gioelemigno/Home-Net-System-Design-and-implementation-of-a-home-automation-system-for-energy-consumption-contro/Home Net System_  Presentation.pdf

Home Net System:

Design and implementation of a home automation system for energy consumption control

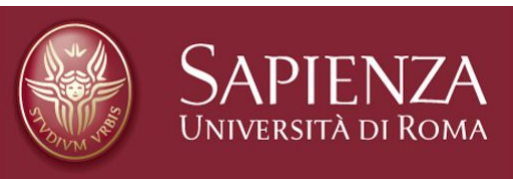
[picture p4: figure]

Candidate: | Gioele Migno 1795826
Thesis Advisor: | Prof. Alessandro Di Giorgio
Co-Advisor: | Prof. Vincenzo Suraci | 10/13/2020

## Introduction

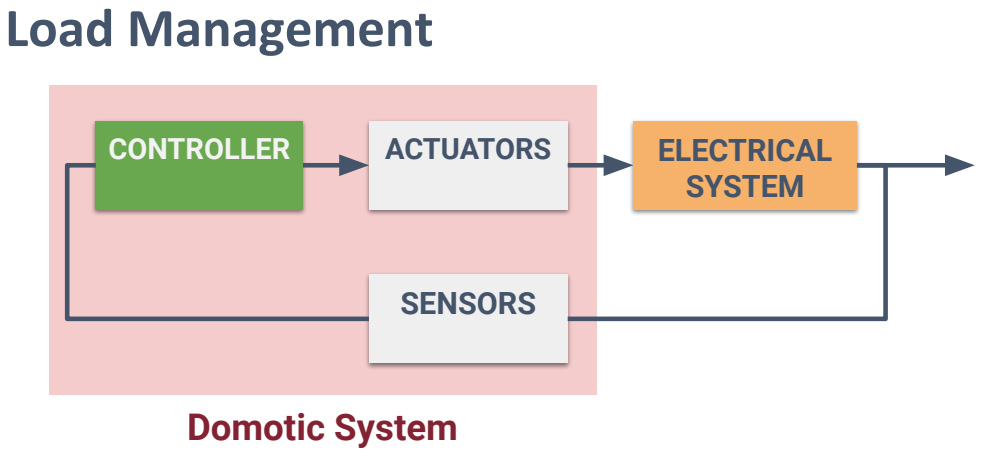
[picture p5: page 4]
CONTROLLER; ELECTRICAL; SYSTEM; SENSORS; ACTUATORS; Domotic System

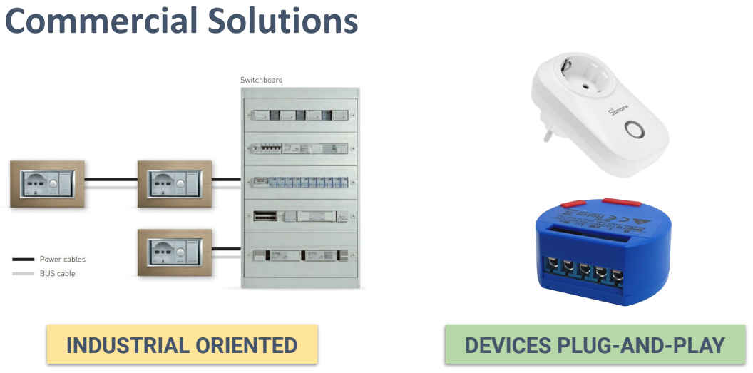
[picture p6: page 5]
INDUSTRIAL ORIENTED; DEVICES PLUG-AND-PLAY

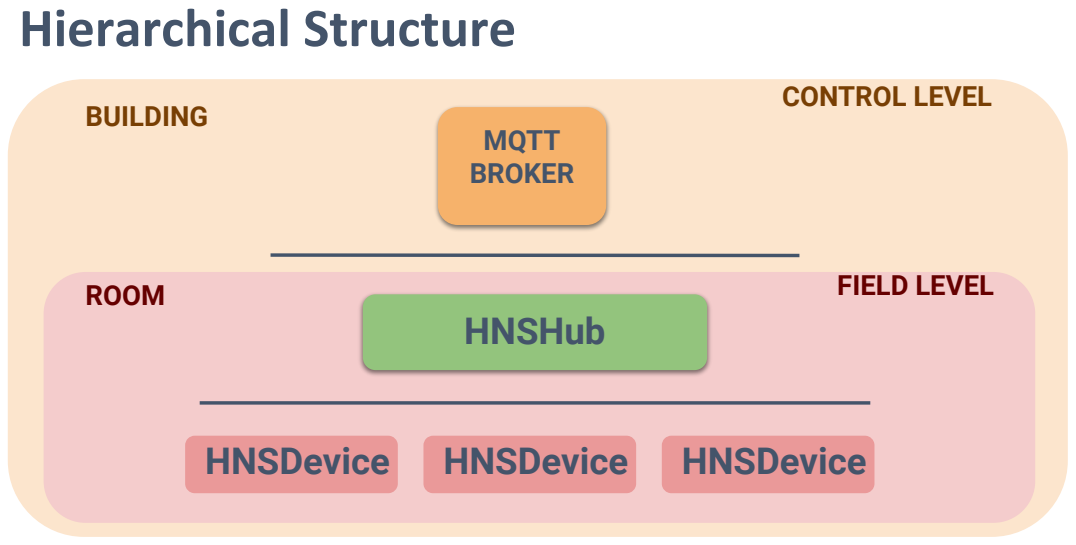
[picture p7: page 6]
HNSHub; MQTT BROKER; HNSDevice; ROOM; BUILDING; CONTROL LEVEL; FIELD LEVEL

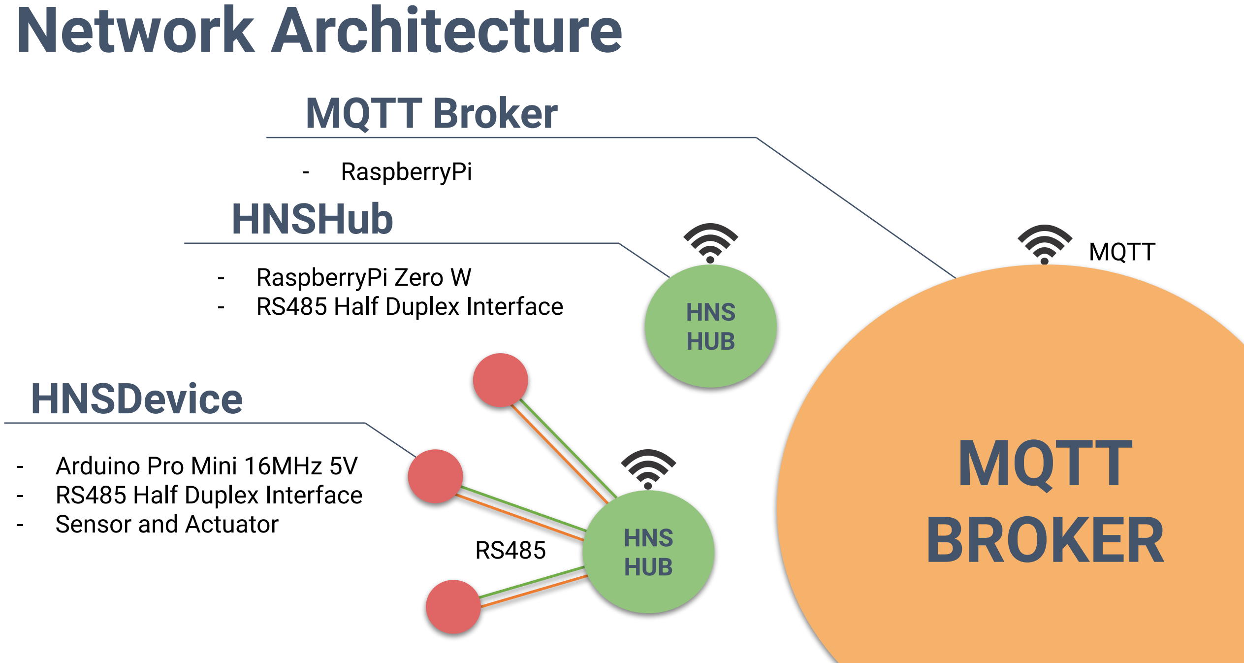
[picture p8: page 7]

HNS
HUB

Network Architecture

HNSDevice

- Arduino Pro Mini 16MHz 5V
- RS485 Half Duplex Interface
- Sensor and Actuator

HNSHub

- RaspberryPi Zero W
- RS485 Half Duplex Interface

MQTT Broker

- RaspberryPi
RS485 | HNS HUB

MQTT

MQTT
BROKER

Communication Example

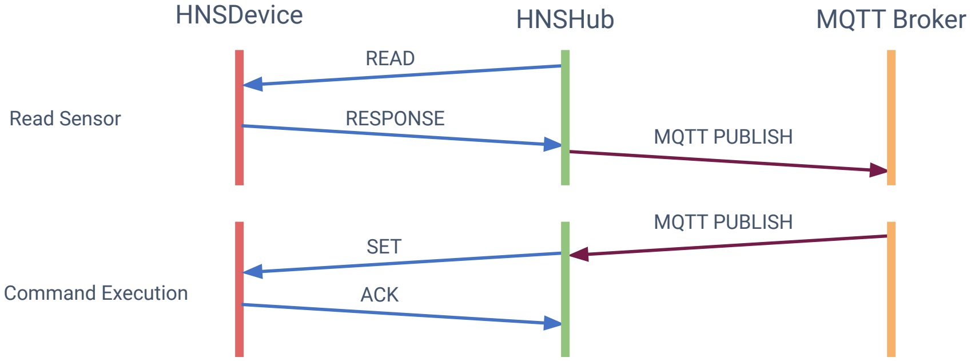
[picture p9: figure]
HNSDevice; HNSHub; MQTT Broker; Read Sensor; Command Execution; READ; RESPONSE; SET; ACK; MQTT PUBLISH

HNSProtocol | MQTT

## Proof of Concept

Hardware setup

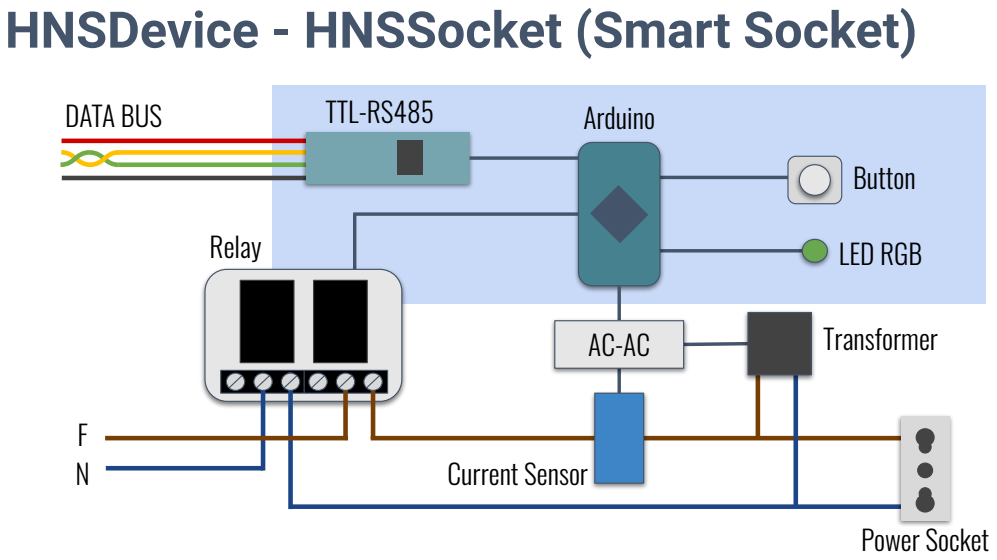
[picture p10: page 10]
Current Sensor; LED RGB; Button; Arduino; Relay; Transformer; DATA BUS; TTL-RS485; Power Socket

HNSDevice - HNSSocket (Smart Socket)

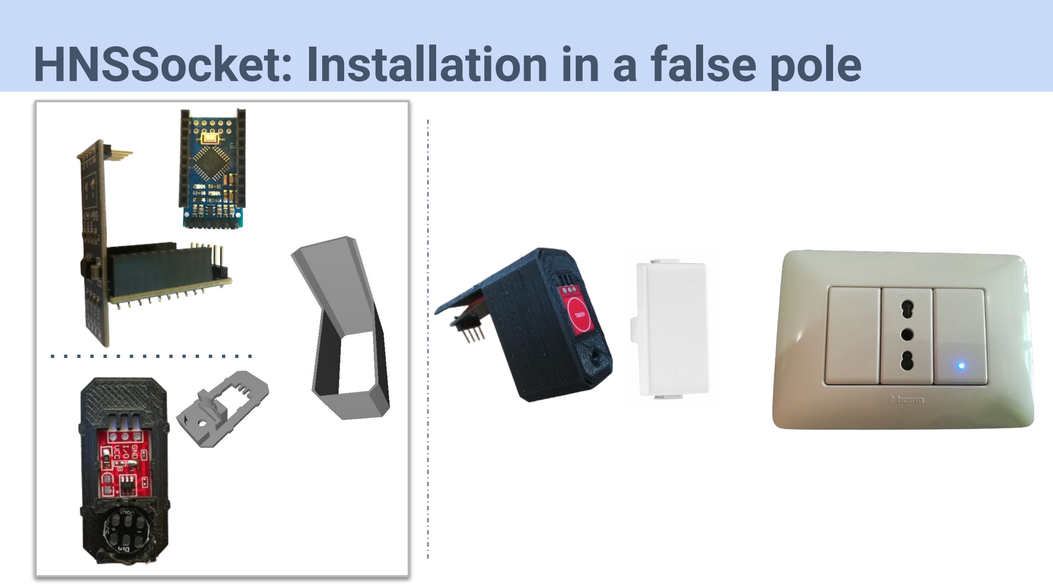
[picture p11: page 11]

HNSSocket: Installation in a false pole

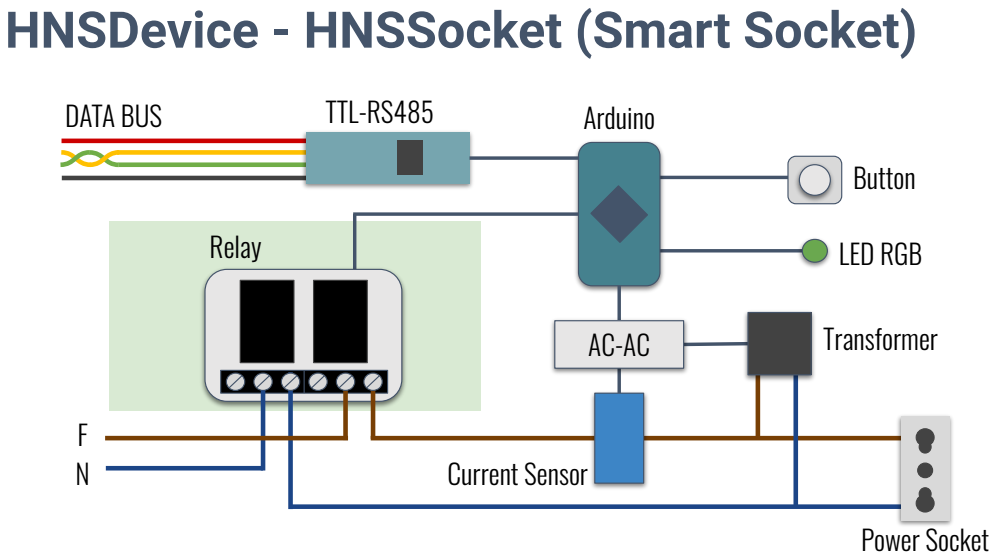
[picture p12: page 12]
Current Sensor; LED RGB; Button; Arduino; Relay; Transformer; DATA BUS; TTL-RS485; Power Socket

HNSDevice - HNSSocket (Smart Socket)

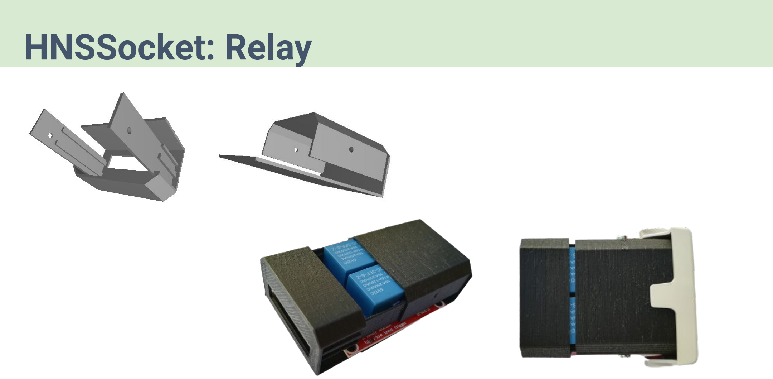
[picture p13: page 13]

HNSSocket: Relay

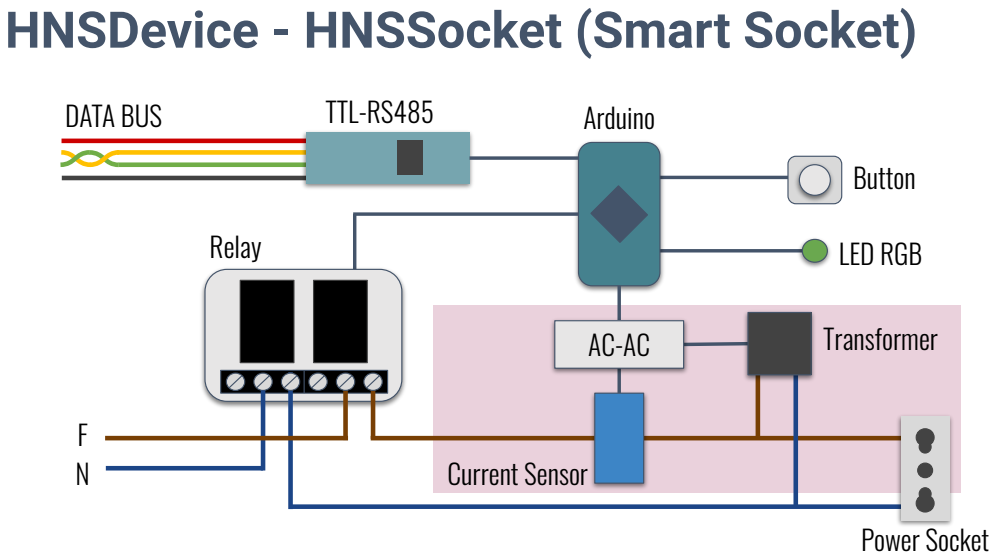
[picture p14: page 14]
Current Sensor; LED RGB; Button; Arduino; Relay; Transformer; DATA BUS; TTL-RS485; Power Socket

HNSDevice - HNSSocket (Smart Socket)

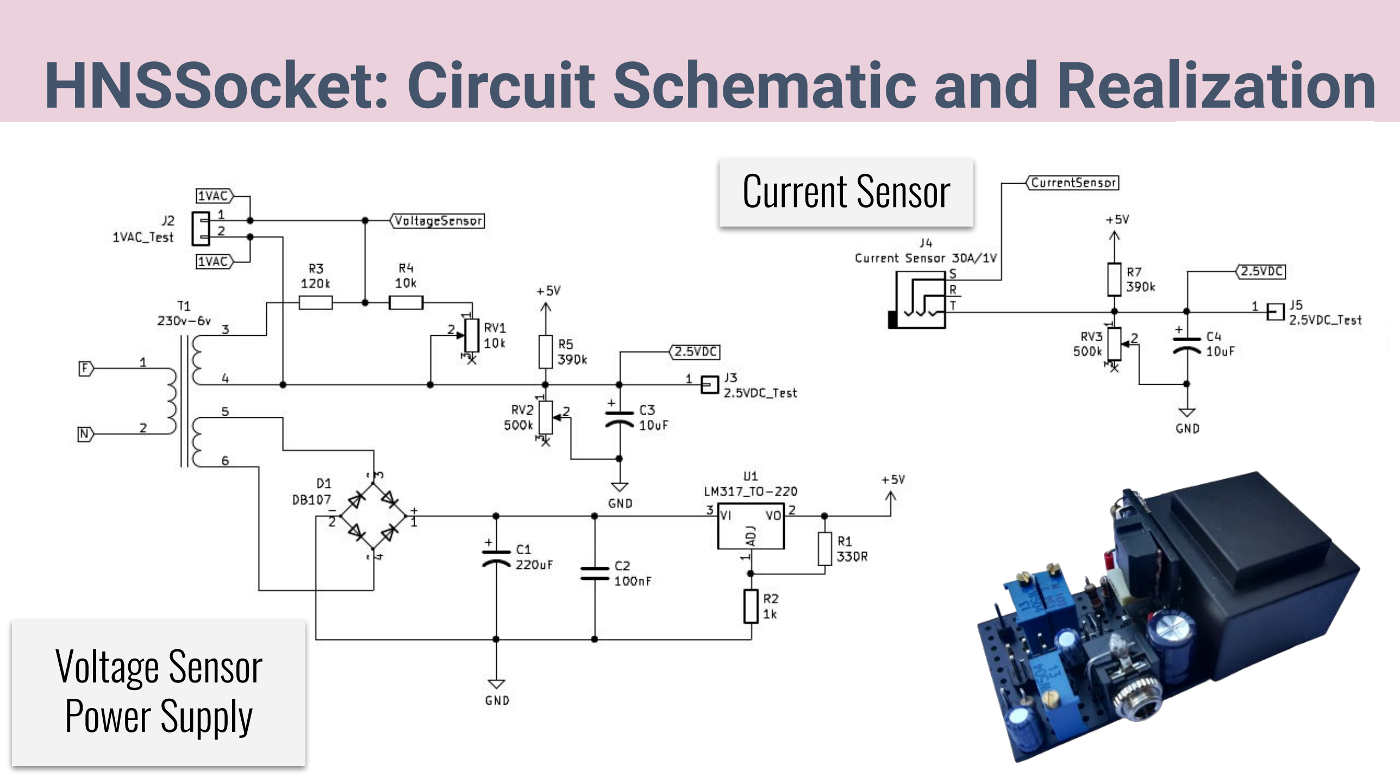
[picture p15: page 15]

HNSSocket: Circuit Schematic and Realization

Voltage Sensor
Power Supply

Current Sensor

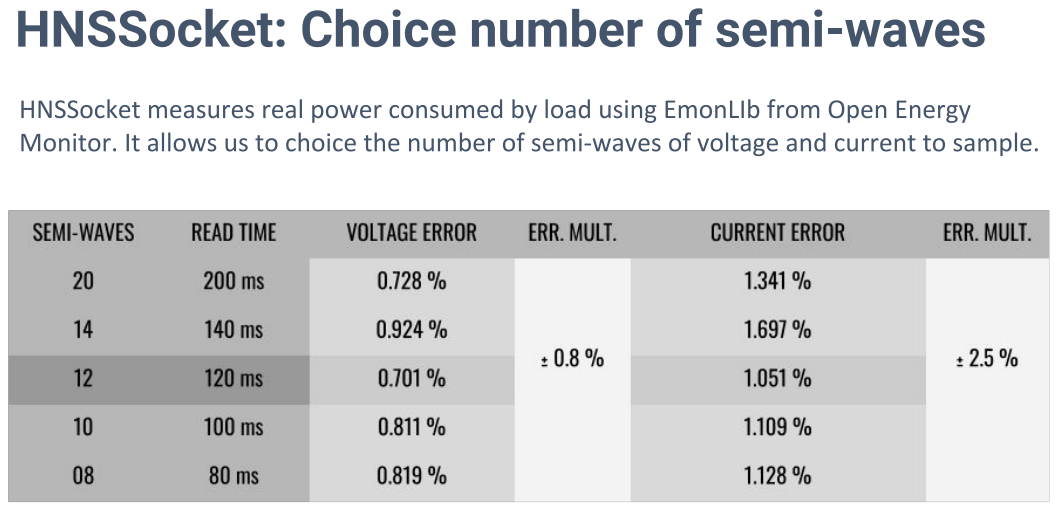
[picture p16: page 16]

HNSSocket: Choice number of semi-waves

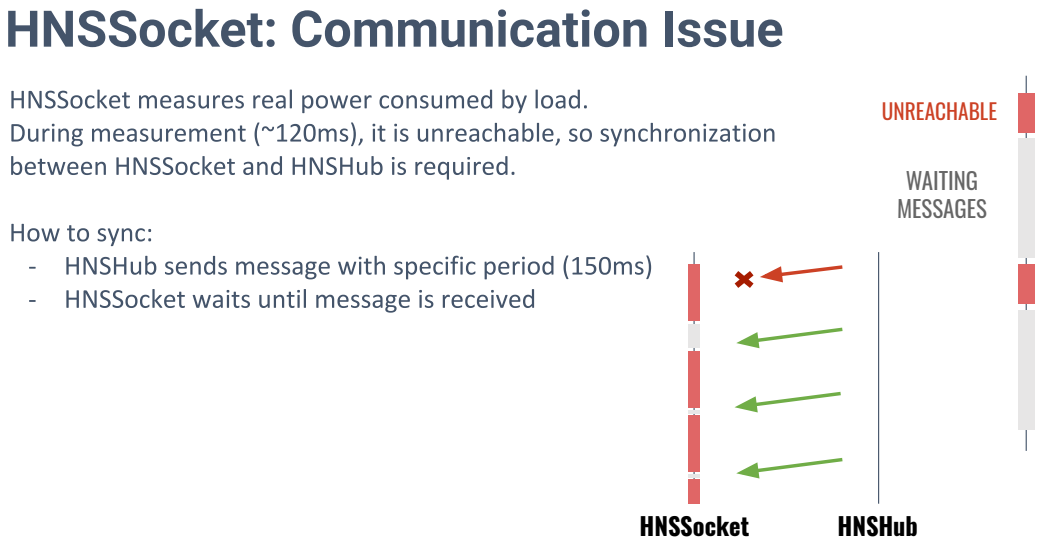
[picture p17: page 17]
UNREACHABLE; WAITING MESSAGES; HNSSocket; HNSHub

HNSSocket: Communication Issue

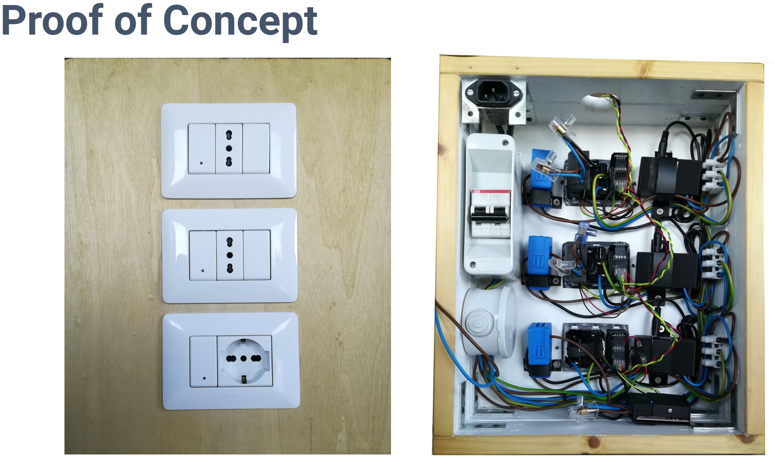
[picture p18: page 18]

Proof of Concept

## GUI

Example: Smart Socket

NodeRed Dashboard

SOCKET | STATISTICAL INFORMATION
REAL POWER | SWITCH COMMAND

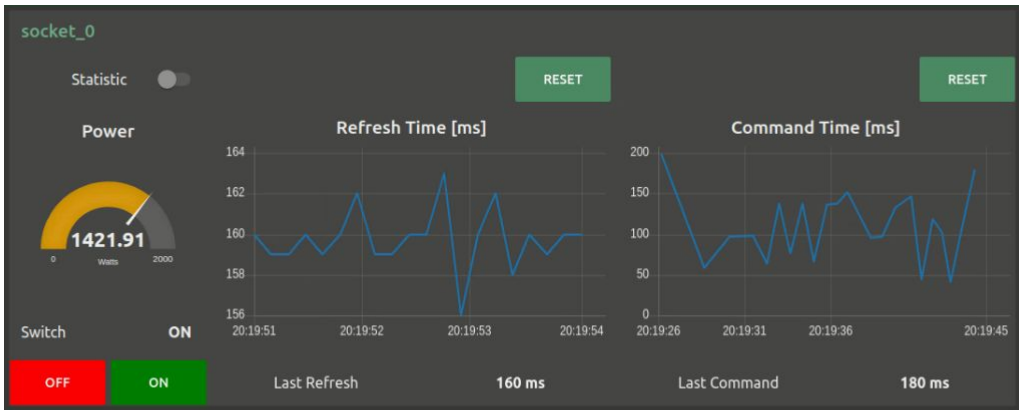
[picture p19: figure]

NodeRed Dashboard: Refresh Time

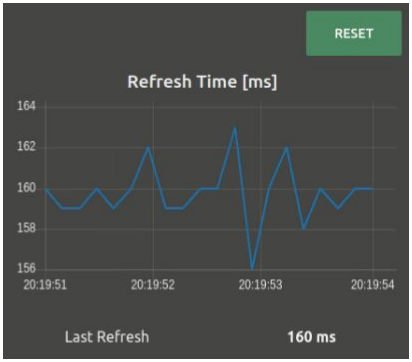
[picture p20: figure]
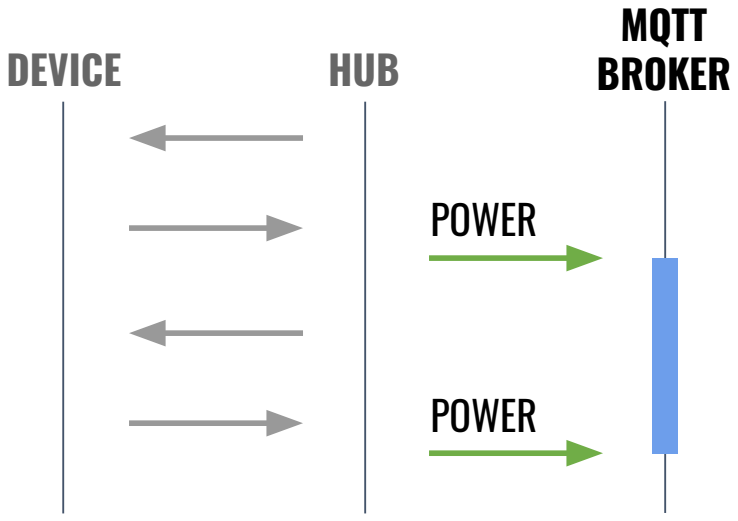
[picture p21: figure]
DEVICE; HUB; MQTT BROKER; POWER

NodeRed Dashboard: Command Time

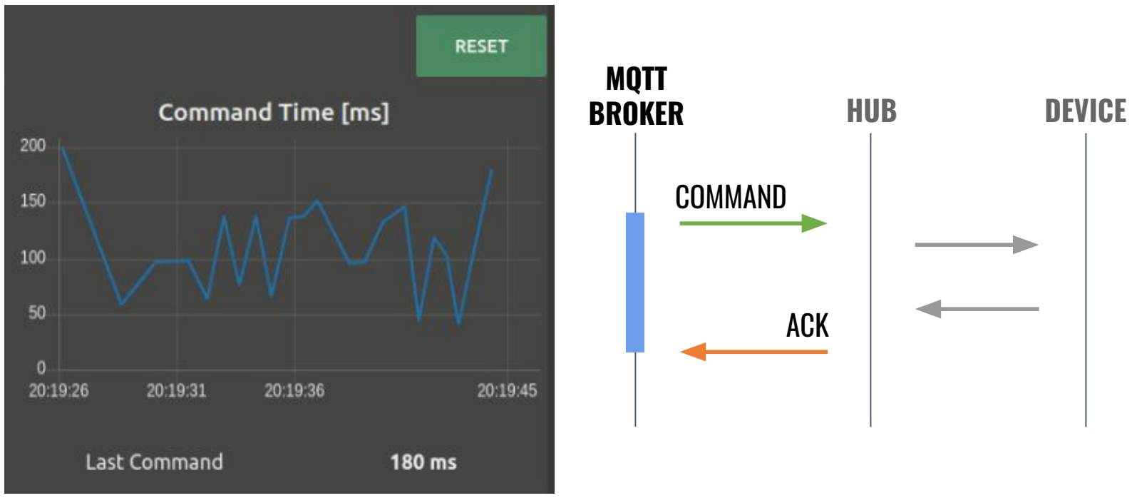
[picture p22: figure]
HUB; DEVICE; MQTT BROKER; ACK; COMMAND

Thanks for the attention
