gioelemigno/Home-Net-System-Design-and-implementation-of-a-home-automation-system-for-energy-consumption-contro/src/lib_common/HNSCore/HNSMacro.h

 /*****************************************************************************
 *
 * FILENAME :    	    				HNSMacro.h                			DESIGN REF: 00 0X
 *
 * DESCRIPTION :
 *       This file contains the value of macros used in other file.
 *			 There are these types of macros:
 *					-	type of trasmission
 *					-	flag to specif error
 *
 * PUBLIC FUNCTIONS :
 *			 none
 *
 * NOTES :
 *
 *
 * AUTHOR :    Gioele Migno      START DATE :    04 july 2017
 *       (gioele.migno@gmail.com)
 *
 * CHANGES :
 *
 * REF NO   VERSION       DATE        WHO      DETAIL
 *   00     v.0.4.2      04July17      GM       File creation
 *
 *****************************************************************************/

 /******************************************************************************
 *
 *    LICENSE:  GNU General Public License v3.0
 *
 ******************************************************************************/

#ifndef HNSMACRO_H_
#define HNSMACRO_H_


//	TYPES OF TRASMISSION	:		[0	-	249] [250 - 254]
/*****************************************************************************/
// Special type :
	#define ACK 									253
	#define ADDRESS_ASSIGNMENT						252
	#define SEND_MODEL								251
	#define SYNC									250

//	Read:	(they are used by master)
	#define READ_ALL 								249
	#define READ_1	                				248
	#define READ_2	                				247
	#define READ_3	                				246
	#define READ_4	                				245
	#define READ_5	                				244
	#define READ_6	                				243
	#define READ_7									242
	#define READ_8									241
	#define READ_9									240
	#define READ_10									239
	#define READ_11									238
	#define READ_12									237
  	#define READ_13									236
	#define READ_14									235
	#define READ_15									234
	#define READ_16									233
	#define READ_17									232
	#define READ_18									231
	#define READ_19									230
	#define READ_20									229
	#define READ_21									228
	#define READ_22									227
	#define READ_23									226
	#define READ_24									225
	#define READ_25									224
	#define READ_26									223
	#define READ_27									222
	#define READ_28									221
	#define READ_29									220
	#define READ_30									219
	#define READ_31									218

//	Set:	(they are used by master)
	#define SET 										217
	#define SET_1										216
	#define SET_2										215
	#define SET_3										214
	#define SET_4										213
	#define SET_5										212
	#define SET_6										211
	#define SET_7										210
	#define SET_8										209
	#define SET_9										208
	#define SET_10									207
	#define SET_11									206
	#define SET_12									205
	#define SET_13									204
	#define SET_14									203
	#define SET_15									202
	#define SET_16									201
	#define SET_17									200
	#define SET_18									199
	#define SET_19									198
	#define SET_20									197
	#define SET_21									196
	#define SET_22									195
	#define SET_23									194
	#define SET_24									193
	#define SET_25									192
	#define SET_26									191
	#define SET_27									190
	#define SET_28									189
	#define SET_29									188
	#define SET_30									187
	#define SET_31									186

	//	Other types	:
	#define RESPONSE_0							185			//it used by slave to give a
																					//information to master
	#define RESPONSE_1	184
	#define RESPONSE_2	183
	#define RESPONSE_3	182
	#define RESPONSE_4	181
	#define RESPONSE_5	180
	#define RESPONSE_6	179
	#define RESPONSE_7	178
	#define RESPONSE_8	177
	#define RESPONSE_9	176
	#define RESPONSE_10	175
	#define RESPONSE_11	174
	#define RESPONSE_12	173
	#define RESPONSE_13	172
	#define RESPONSE_14	171
	#define RESPONSE_15	170
	#define RESPONSE_16	169
	#define RESPONSE_17	168
	#define RESPONSE_18	167
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
	#define STATUS_POWER_ALLARM STATUS_4

/*****************************************************************************/
/***************************** STANDARD TYPE **********************************/


	#define SET_STATUS_ON   SET_31
    #define SET_STATUS_OFF  SET_30

	//master ask only changes
	#define REFRESH 			READ_31
	#define REFRESH_ALL 		READ_30
	//response to REFRESH when only chip temperature changed
	#define RSP_ONLY_TEMP 			RESPONSE_31
	
	//response to REFRESH when nothing changed
	#define RSP_NO_CHANGE 		RESPONSE_30

	//indicates number of sub thing inside data (not considering chip_temperature)
	// in this case, there is always chip_temperature !!!
	// For example, in HNSocketPOwer, indicates number of subSocket 
	#define RSP_REFRESH_1		RESPONSE_29
	#define RSP_REFRESH_2		RESPONSE_28	
	#define RSP_REFRESH_3		RESPONSE_27
	#define RSP_REFRESH_4		RESPONSE_26
	
	//response to REFRESH_ALL 
	#define RSP_REFRESH_ALL				RESPONSE_25

	#define RSP_SET_STATUS_ON		RESPONSE_24
	#define RSP_SET_STATUS_OFF		RESPONSE_23
	#define RSP_SET_STATUS_ALLARM 	RESPONSE_22
/******************************************************************************/


// REMOVE THIS!!
#include "HNSCore.h"



#endif /* HNSMACRO_H_ */
